vtrivedi123/Flight_Controller/Lab8_Flightboard_Starter.kicad_pcb

## KiCad design Lab8_Flightboard_Starter.kicad_pcb (2026-10-14)

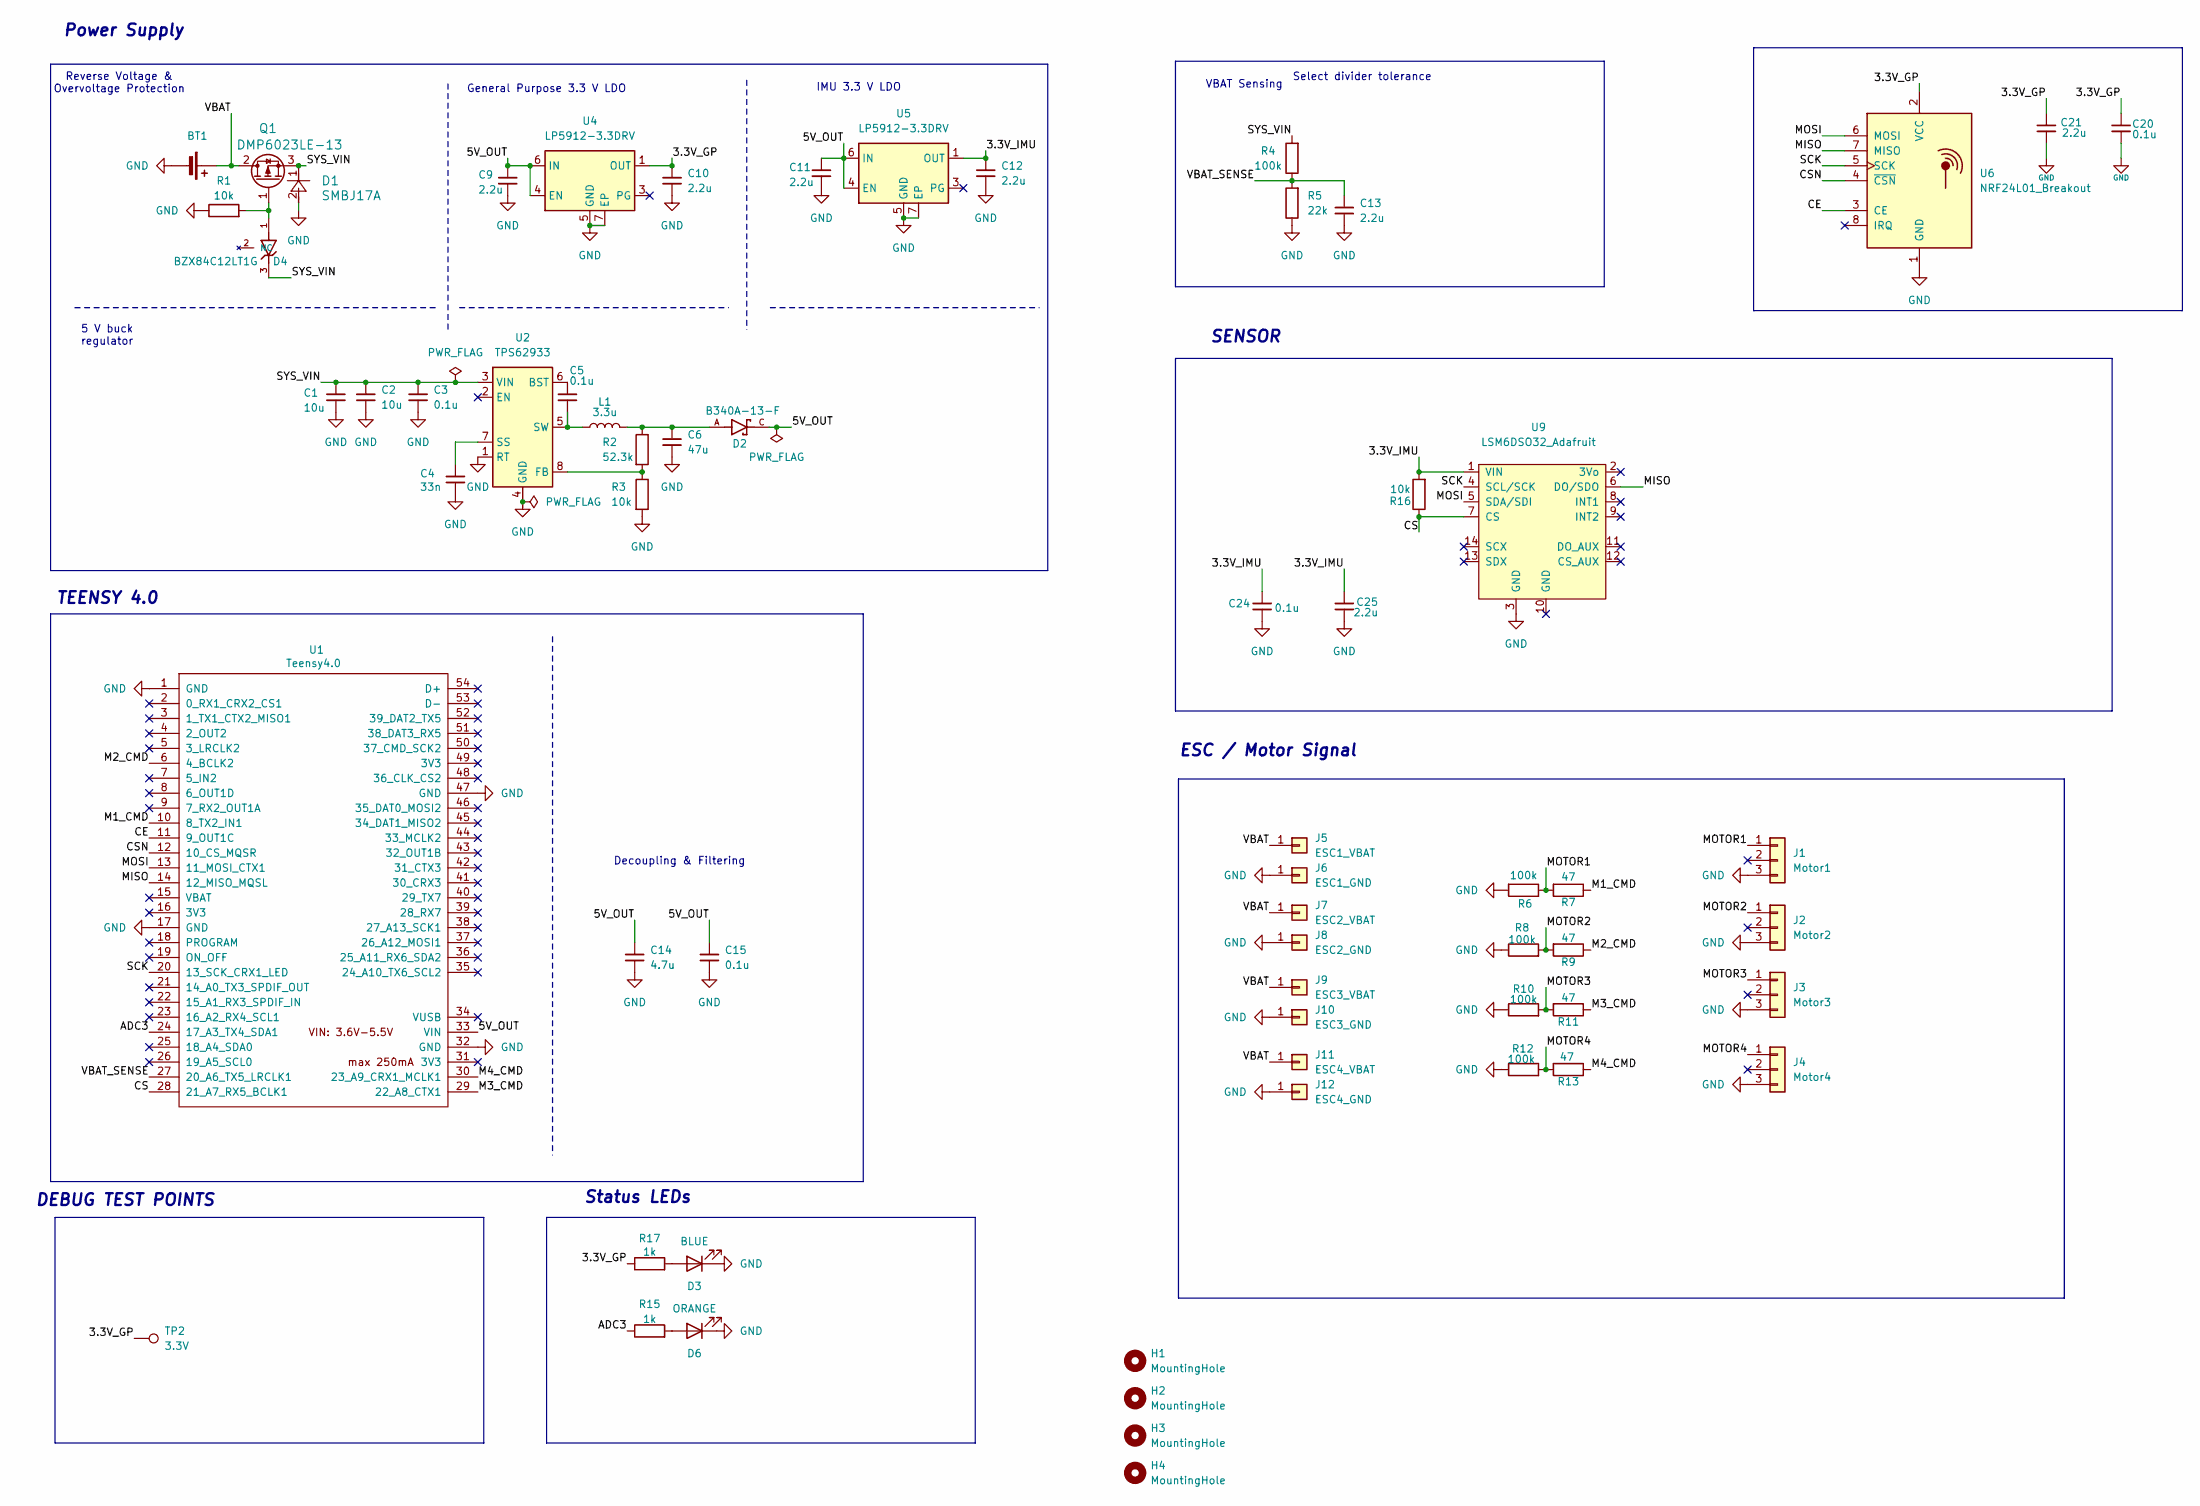
[picture p1: schematic Lab8_Flightboard_Starter.kicad_sch]

Parts:
BT1: 3S_LiPo; Pad_x2
C1, C2: 10u; C_1206_3216Metric_Pad1.33x1.80mm_HandSolder
C3, C5, C15, C20, C24: 0.1u; C_0805_2012Metric_Pad1.18x1.45mm_HandSolder
C4: 33n; C_0805_2012Metric_Pad1.18x1.45mm_HandSolder
C6: 47u; C_1206_3216Metric_Pad1.33x1.80mm_HandSolder
C9, C10, C11, C12, C13, C21, C25: 2.2u; C_0805_2012Metric_Pad1.18x1.45mm_HandSolder
C14: 4.7u; C_0805_2012Metric_Pad1.18x1.45mm_HandSolder
D1: SMBJ17A; SMBJSeries_LTF
D2: B340A-13-F; DIOM5226X240N; PARTREV 17-2
D3: BLUE; LED_0805_2012Metric_Pad1.15x1.40mm_HandSolder
D4: BZX84C12LT1G; SOT95P240X111-3N; PARTREV 23
D6: ORANGE; LED_0805_2012Metric_Pad1.15x1.40mm_HandSolder
H1, H2, H3, H4: MountingHole; MountingHole_3.3mm_no-courtyard
J1: Motor1; PinHeader_1x03_P2.54mm_Vertical
J2: Motor2; PinHeader_1x03_P2.54mm_Vertical
J3: Motor3; PinHeader_1x03_P2.54mm_Vertical
J4: Motor4; PinHeader_1x03_P2.54mm_Vertical
J5: ESC1_VBAT; Pad_x1_6mm
J6: ESC1_GND; Pad_x1_6mm
J7: ESC2_VBAT; Pad_x1_6mm
J8: ESC2_GND; Pad_x1_6mm
J9: ESC3_VBAT; Pad_x1_6mm
J10: ESC3_GND; Pad_x1_6mm
J11: ESC4_VBAT; Pad_x1_6mm
J12: ESC4_GND; Pad_x1_6mm
L1: 3.3u; IND_SRP7028A-4R7M_BRN
Q1: DMP6023LE-13; DMP6023LE-13_Official
R1, R3, R16: 10k; R_0805_2012Metric_Pad1.20x1.40mm_HandSolder
R2: 52.3k; R_0805_2012Metric_Pad1.20x1.40mm_HandSolder
R4, R6, R8, R10, R12: 100k; R_0805_2012Metric_Pad1.20x1.40mm_HandSolder
R5: 22k; R_0805_2012Metric_Pad1.20x1.40mm_HandSolder
R7, R9, R11, R13: 47; R_0805_2012Metric_Pad1.20x1.40mm_HandSolder
R15, R17: 1k; R_0805_2012Metric_Pad1.20x1.40mm_HandSolder
TP2: 3.3V; TestPoint_Pad_2.0x2.0mm
U1: Teensy4.0; Teensy40
U2: TPS62933; SOT-583-8
U4, U5: LP5912-3.3DRV; WSON-6-1EP_2x2mm_P0.65mm_EP1x1.6mm_ThermalVias
U6: NRF24L01_Breakout; nRF24L01_Breakout
U9: LSM6DSO32_Adafruit

Connections:
/3.3V_GP: C10.1, C20.1, C21.1, R17.1, TP2.1 (1_1), U4.1 (OUT), U6.2 (VCC)
/3.3V_IMU: C12.1, C24.1, C25.1, R16.2, U5.1 (OUT), U9.1 (VIN)
/5V_OUT: C9.1, C11.1, C14.1, C15.1, D2.C, U1.33 (VIN), U4.4 (EN), U4.6 (IN), U5.4 (EN), U5.6 (IN)
/ADC3: R15.1, U1.24 (17_A3_TX4_SDA1)
/CE: U1.11 (9_OUT1C), U6.3 (CE)
/CS: R16.1, U1.28 (21_A7_RX5_BCLK1), U9.7 (CS)
/CSN: U1.12 (10_CS_MQSR), U6.4 (~CSN)
/M1_CMD: R7.1, U1.10 (8_TX2_IN1)
/M2_CMD: R9.1, U1.6 (4_BCLK2)
/M3_CMD: R11.1, U1.29 (22_A8_CTX1)
/M4_CMD: R13.1, U1.30 (23_A9_CRX1_MCLK1)
/MISO: U1.14 (12_MISO_MQSL), U6.7 (MISO), U9.6 (DO/SDO)
/MOSI: U1.13 (11_MOSI_CTX1), U6.6 (MOSI), U9.5 (SDA/SDI)
/MOTOR1: J1.1, R6.1, R7.2
/MOTOR2: J2.1, R8.2, R9.2
/MOTOR3: J3.1, R10.2, R11.2
/MOTOR4: J4.1, R12.2, R13.2
/SCK: U1.20 (13_SCK_CRX1_LED), U6.5 (SCK), U9.4 (SCL/SCK)
/SYS_VIN: C1.1, C2.1, C3.1, D1.1, D4.3, Q1.3, R4.2, U2.3 (VIN)
/VBAT: BT1.1 (+), J5.1 (Pin_1_1), J7.1 (Pin_1_1), J9.1 (Pin_1_1), J11.1 (Pin_1_1), Q1.2
/VBAT_SENSE: C13.1, R4.1, R5.2, U1.27 (20_A6_TX5_LRCLK1)
GND: BT1.2 (-), C1.2, C2.2, C3.2, C4.1, C6.2, C9.2, C10.2, C11.2, C12.2, C13.2, C14.2, C15.2, C20.2, C21.2, C24.2, C25.2, D1.2, D3.1 (K), D6.1 (K), J1.3, J2.3, J3.3, J4.3, J6.1 (Pin_1_1), J8.1 (Pin_1_1), J10.1 (Pin_1_1), J12.1 (Pin_1_1), R1.1, R3.2, R5.1, R6.2, R8.1, R10.1, R12.1, U1.1 (GND), U1.17 (GND), U1.32 (GND), U1.47 (GND), U2.1 (RT), U2.4 (GND), U4.5 (GND), U4.7 (EP), U5.5 (GND), U5.7 (EP), U6.1 (GND), U9.3 (GND)
unnamed: C6.1, D2.A, L1.2, R2.1
unnamed: D3.2 (A), R17.2
unnamed: D4.1, Q1.1, R1.2
unnamed: D6.2 (A), R15.2
unnamed: C5.1, U2.6 (BST)
unnamed: R2.2, R3.1, U2.8 (FB)
unnamed: C4.2, U2.7 (SS)
unnamed: C5.2, L1.1, U2.5 (SW)

Notes on the sheet:
SENSOR
Power Supply
VBAT Sensing
5 V buck regulator
Status LEDs
IMU 3.3 V LDO
Select divider tolerance
Decoupling & Filtering
DEBUG TEST POINTS
TEENSY 4.0
ESC / Motor Signal
Reverse Voltage & Overvoltage Protection
General Purpose 3.3 V LDO

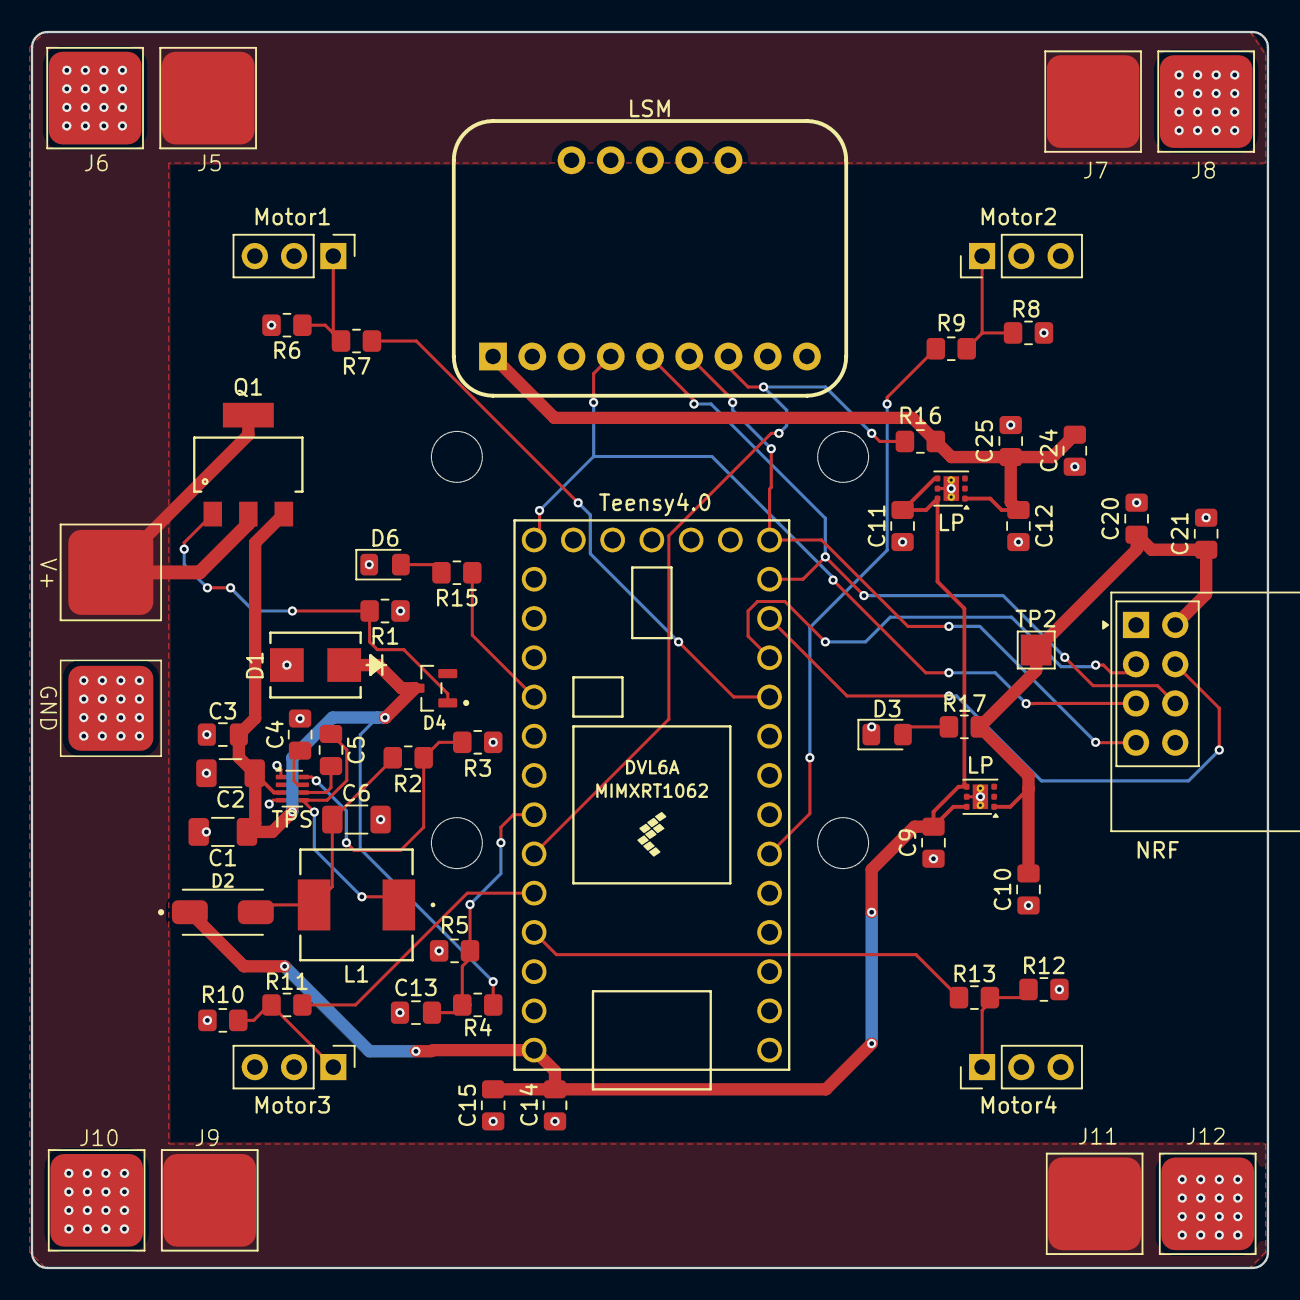
[picture p2: board Lab8_Flightboard_Starter.kicad_pcb from above]

Board: 2 copper layers, 80.0 x 80.0 mm, 64 parts (0 on the bottom side), 30 nets.
