vtrivedi123/Flight_Controller/(commit log)

2026-10-08 Added all files
    [Lab8_Flightboard_Starter.kicad_pcb, Lab8_Flightboard_Starter.kicad_sch]
2026-10-08 Reverse voltage and 5V buck circuits
    [Lab8_Flightboard_Starter.kicad_sch]
2026-10-08 Circuit update V2
    [Lab8_Flightboard_Starter.kicad_sch]
2026-10-08 Added values
    [Lab8_Flightboard_Starter.kicad_sch]
2026-10-08 Motor signals
    [Lab8_Flightboard_Starter.kicad_sch]
2026-10-08 Fixed files
    [Lab8_Flightboard_Starter.kicad_sch]
2026-10-08 Edited circuits
    [Lab8_Flightboard_Starter.kicad_sch]
2026-10-08 More changes
    [Lab8_Flightboard_Starter.kicad_sch]
2026-10-10 Added all component values
    [Lab8_Flightboard_Starter.kicad_sch]
2026-10-10 Forgot some values, updated it
    [Lab8_Flightboard_Starter.kicad_sch]
2026-10-10 Updated wiring and values
    [Lab8_Flightboard_Starter.kicad_sch]
2026-10-10 orientation change
    [Lab8_Flightboard_Starter.kicad_sch]
2026-10-10 more orientation
    [Lab8_Flightboard_Starter.kicad_sch]
2026-10-10 moved MCU a little
    [Lab8_Flightboard_Starter.kicad_sch]
2026-10-10 Fixed ground nodes
    [Lab8_Flightboard_Starter.kicad_sch]
2026-10-10 Fixed more ground nodes
    [Lab8_Flightboard_Starter.kicad_sch]
2026-10-10 Added no connects to MCU
    [Lab8_Flightboard_Starter.kicad_sch]
2026-10-10 Few design updates
    [Lab8_Flightboard_Starter.kicad_sch]
2026-10-10 Fixed errors and most warnings
    [Lab8_Flightboard_Starter.kicad_sch]
2026-10-10 Fixed MCU wiring
    [Lab8_Flightboard_Starter.kicad_sch]
2026-10-10 Fixed wire warning
    [Lab8_Flightboard_Starter.kicad_sch]
2026-10-10 Added board edgecuts
    [Lab8_Flightboard_Starter.kicad_pcb]
2026-10-10 Added hole positions
    [Lab8_Flightboard_Starter.kicad_pcb]
2026-10-10 Added key component locations
    [Lab8_Flightboard_Starter.kicad_pcb]
2026-10-10 Added motor through holes
    [Lab8_Flightboard_Starter.kicad_pcb]
2026-10-10 Edited F Silkscreen text
    [Lab8_Flightboard_Starter.kicad_pcb]
2026-10-10 Placed down more components
    [Lab8_Flightboard_Starter.kicad_pcb]
2026-10-10 Added more components
    [Lab8_Flightboard_Starter.kicad_pcb]
2026-10-10 Added some traces
2026-10-10 More traces
2026-10-10 Added all traces (errors still)
2026-10-10 Added BOM and gerber
2026-10-10 generated bom and gerber
2026-10-11 Edited formatting and remade BOM
2026-10-12 Added BOM and gerber for 3.3u inductor
2026-10-13 Updated wiring
2026-10-13 Updated wiring again
2026-10-13 Remade the power plane + updates
2026-10-14 Added 4x4 array for ground vias
